Phillllll123/411-Group-Porject/CIRCUIT SCHEMATIC.pdf

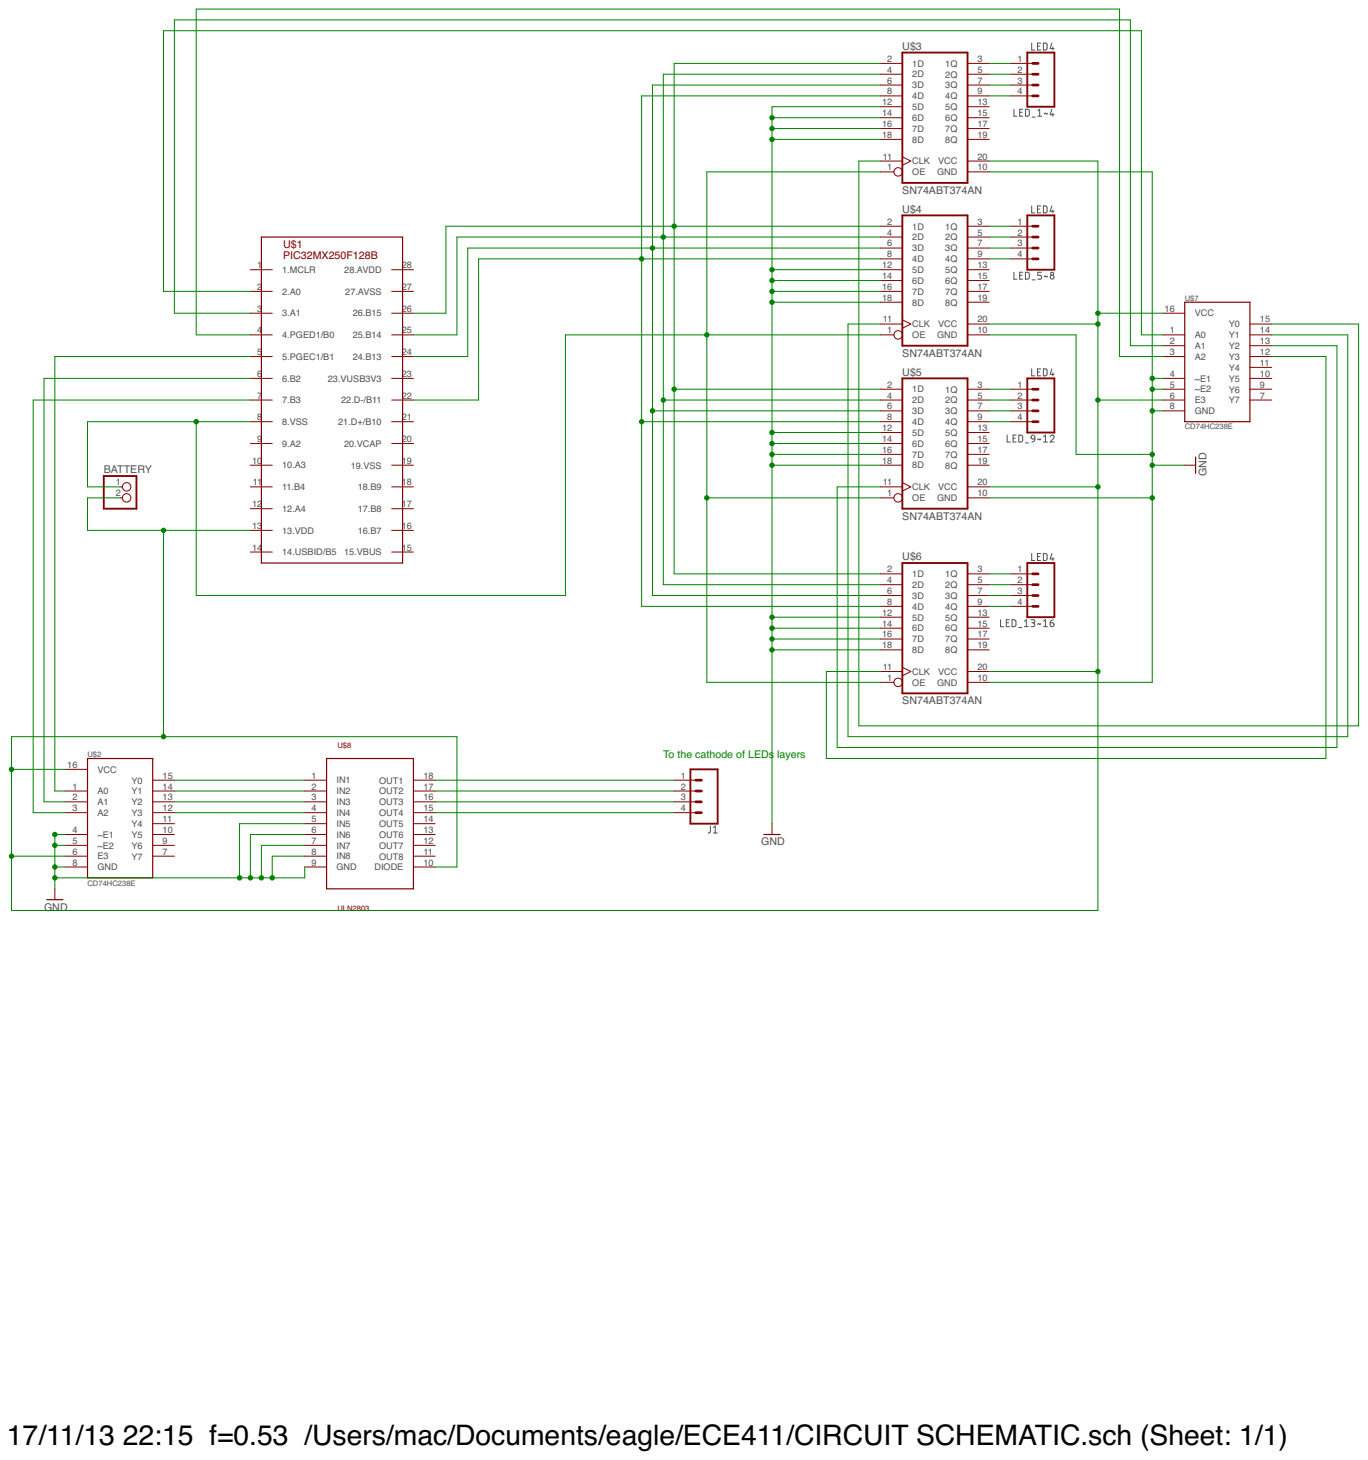
[picture p1: page 1]

4 | | 5 2
6 | | 7 3
8 | | 9 4
12 | | 15 17 19 20 GND

8 | 9 4
12 | 20 GND

4 | 5 2
6 | 7 3
12 | 15 17 19 20 GND

To the cathode of LEDs layers

14 Y0 2 | 17 OUT1 | 2
13 Y1 3 | 16 OUT2 | 3

17/11/13 22:15 f=0.53 /Users/mac/Documents/eagle/ECE411/CIRCUIT SCHEMATIC.sch (Sheet: 1/1)
