Phillllll123/411-Group-Porject/CIRCUIT Layout.pdf

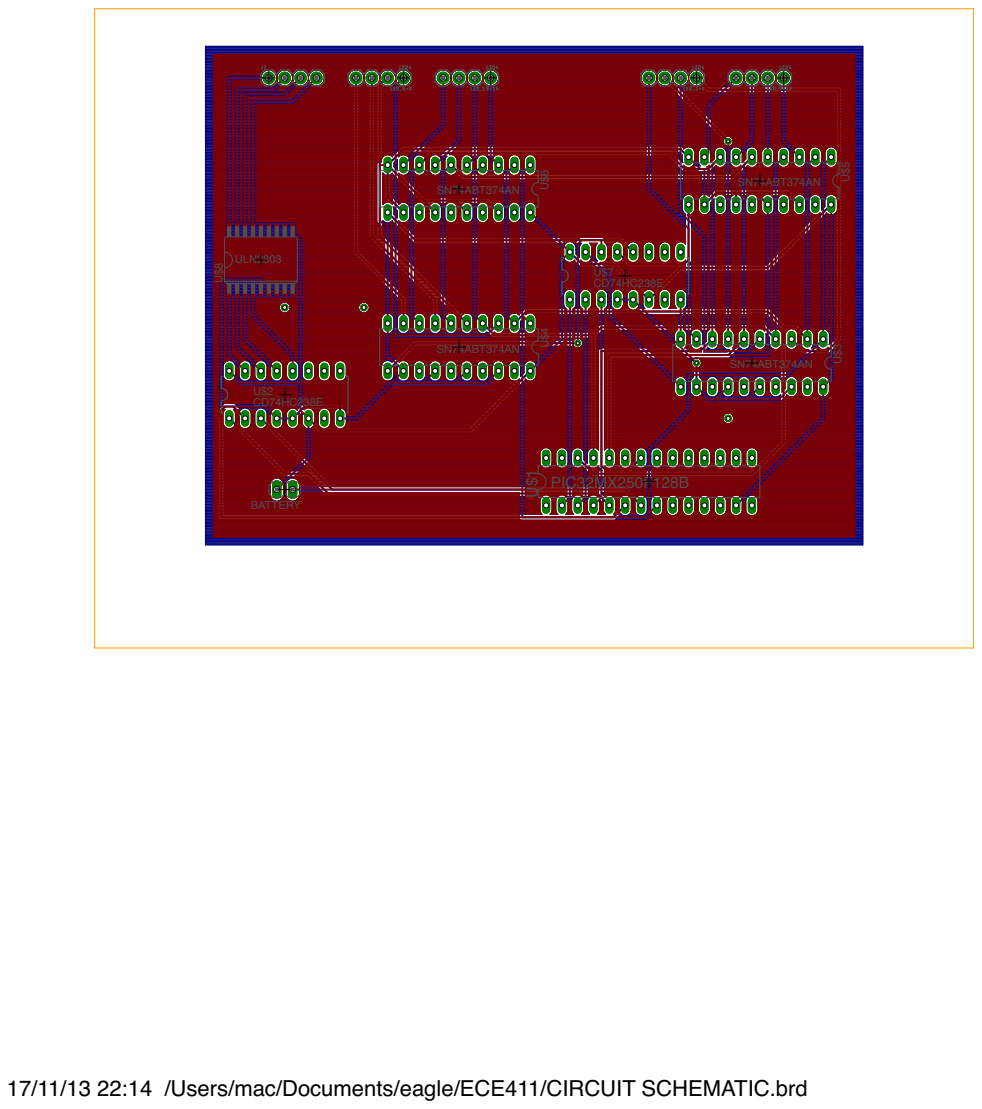
[picture p2: page 1]

U$2 | SN74ABT374AN | U$

17/11/13 22:14 /Users/mac/Documents/eagle/ECE411/CIRCUIT SCHEMATIC.brd
