Phillllll123/411-Group-Porject/LED Cube V6.pdf

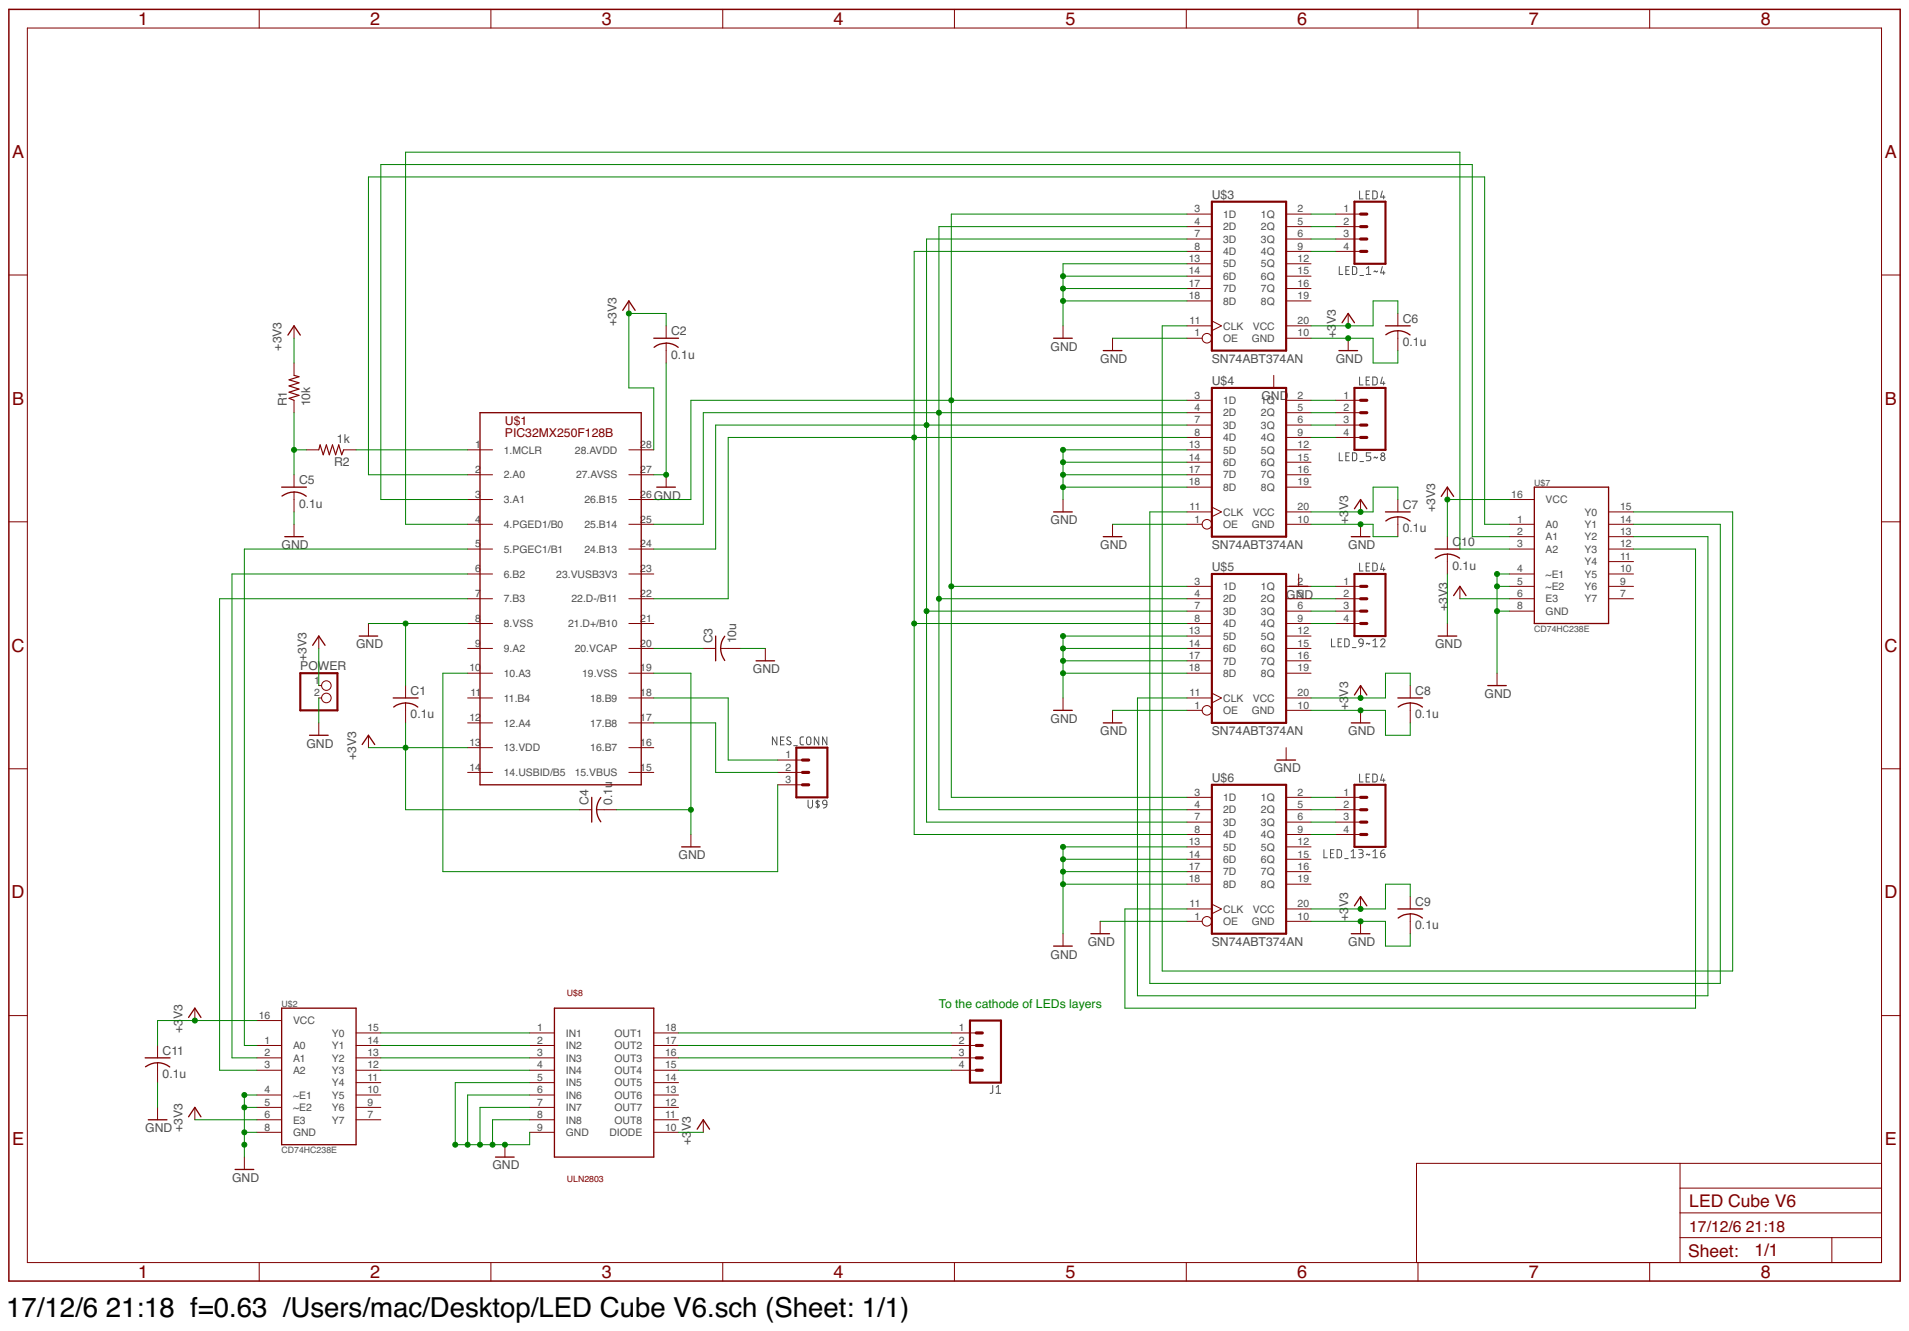
[picture p3: page 1]
