Phillllll123/411-Group-Porject/LED Cube V5.pdf

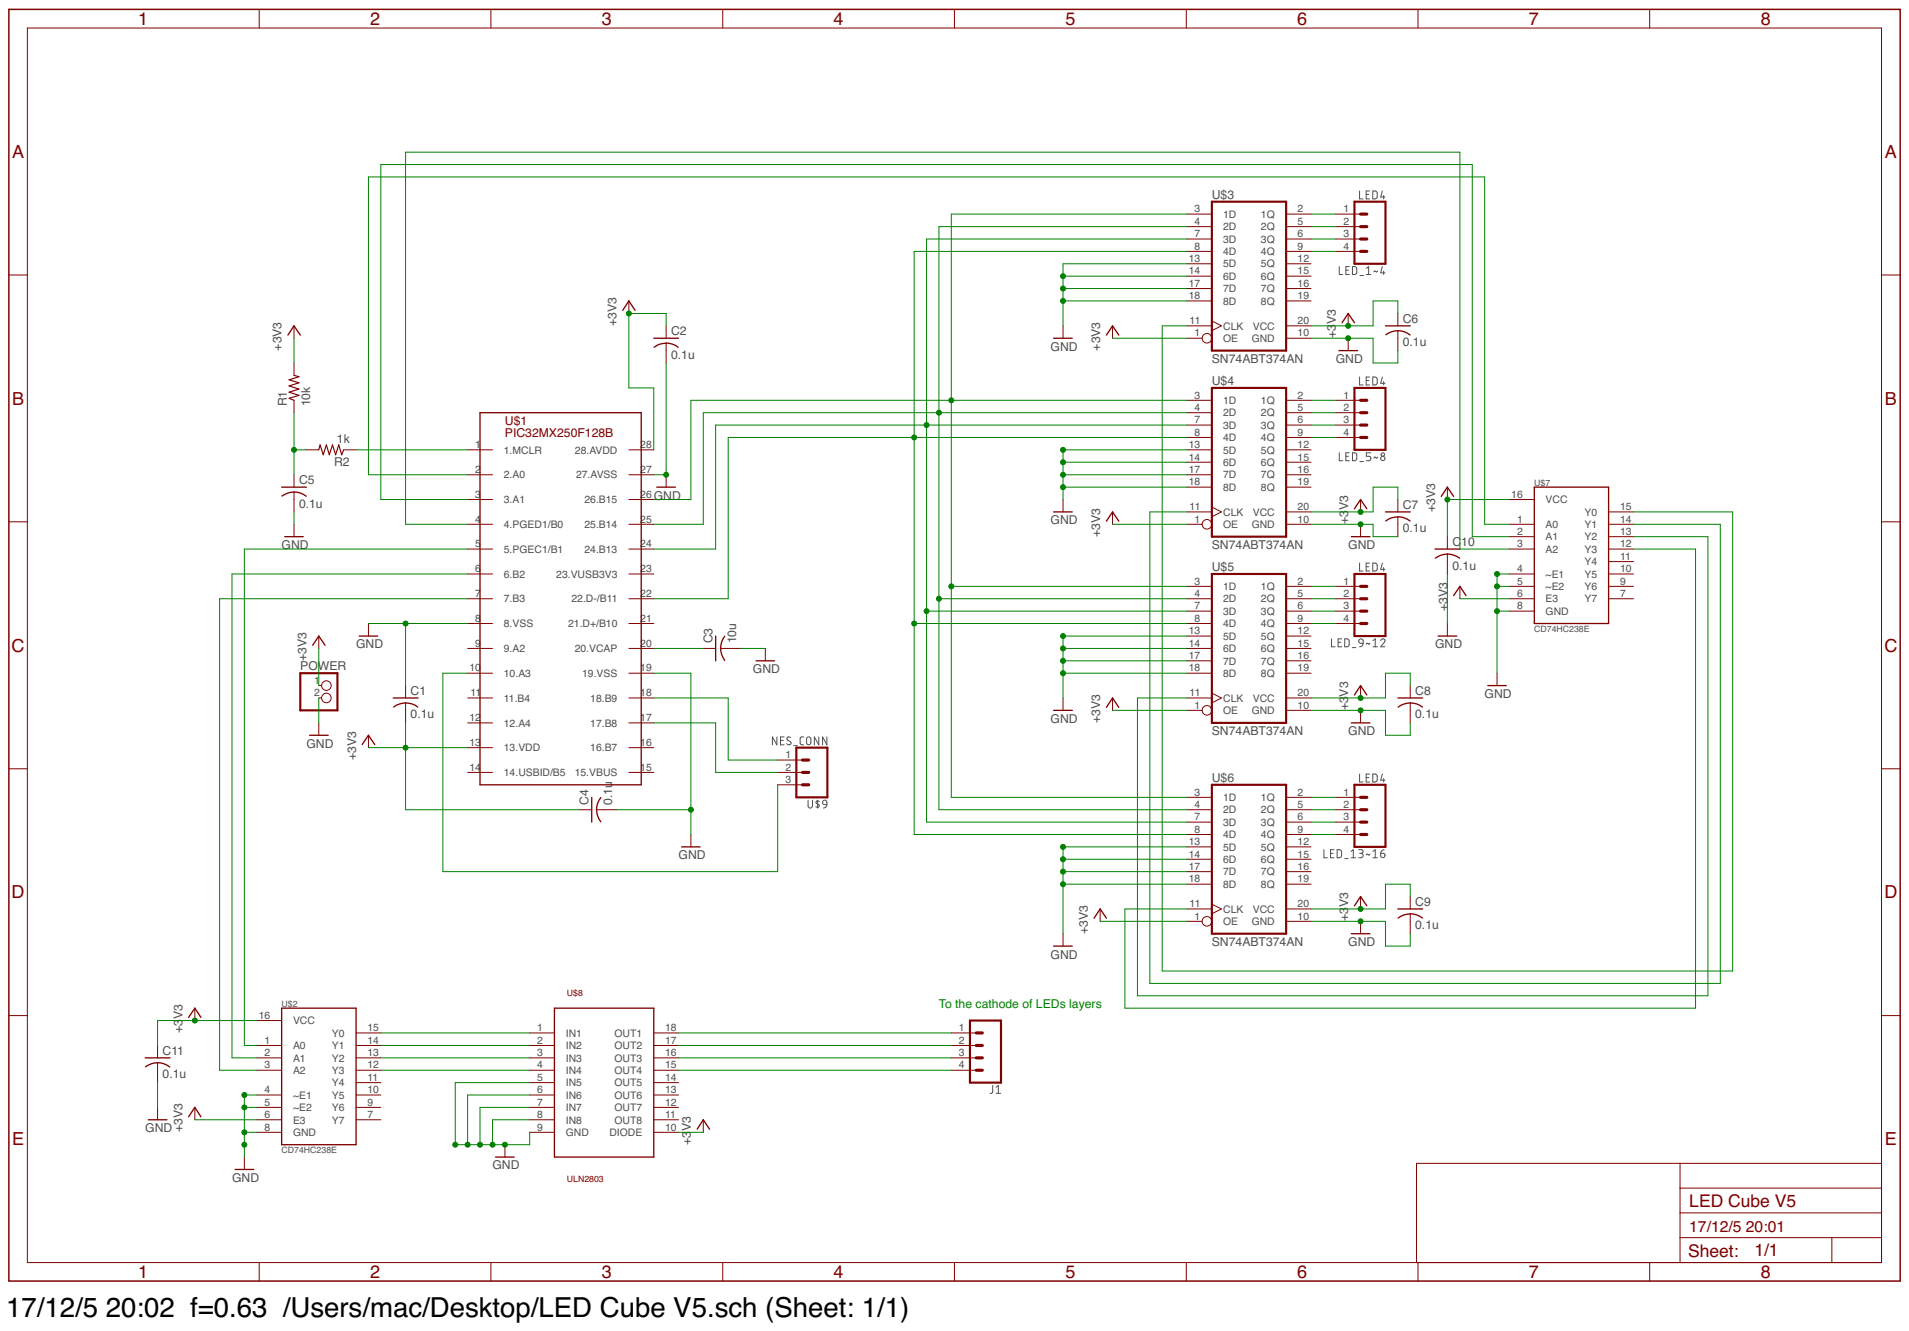
[picture p4: page 1]
