Phillllll123/411-Group-Porject/LED_CUBE_V4.brd

## EAGLE design LED_CUBE_V4.brd (2017-11-16)

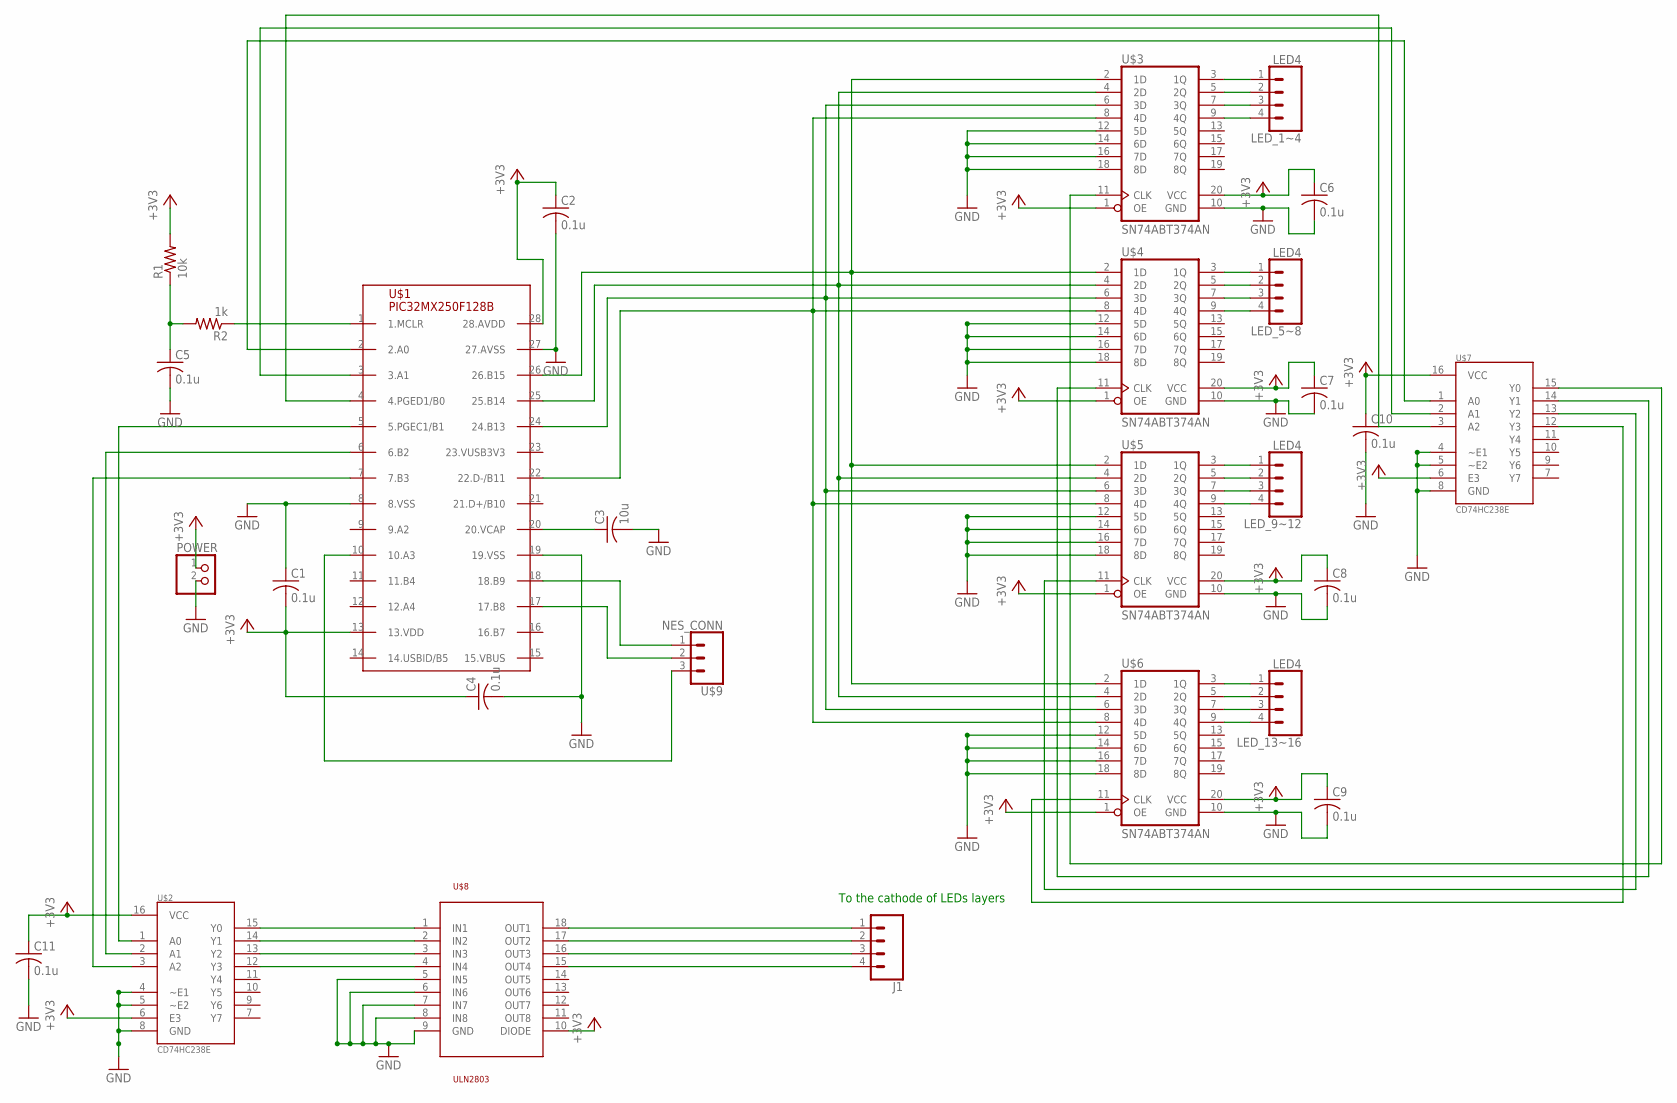
[picture p5: schematic LED_CUBE_V4.sch]

Parts:
C1, C2, C4, C5, C6, C7, C8, C9, C10, C11: 0.1u; C025-025X050
C3: 10u; C025-025X050
J1: CONN_04; 1X04
LED_1~4, LED_5~8, LED_9~12, LED_13~16: LED4; 1X04
POWER: PINHD-1X2; 1X02
R1: 10k; 0204/7
R2: 1k; 0204/7
U$1: PIC32MX250F128B; DIL28-3
U$2, U$7: CD74HC238E; DIL16
U$3, U$4, U$5, U$6: SN74ABT374AN; DIL20
U$8: ULN2803; SO18L
U$9: NES_CONN; 1X03

Connections:
+3V3: C1.2, C2.1, C4.1, C6.1, C7.1, C8.1, C9.1, C10.1, C11.1, POWER.1, R1.2, U$1.13 (13.VDD), U$1.28 (28.AVDD), U$2.6 (E3), U$2.16 (VCC), U$3.1 (OE), U$3.20 (VCC), U$4.1 (OE), U$4.20 (VCC), U$5.1 (OE), U$5.20 (VCC), U$6.1 (OE), U$6.20 (VCC), U$7.6 (E3), U$7.16 (VCC), U$8.10 (DIODE)
GND: C1.1, C2.2, C3.2, C4.2, C5.2, C6.2, C7.2, C8.2, C9.2, C10.2, C11.2, POWER.2, U$1.8 (8.VSS), U$1.19 (19.VSS), U$1.27 (27.AVSS), U$2.4 (~E1), U$2.5 (~E2), U$2.8 (GND), U$3.10 (GND), U$3.12 (5D), U$3.14 (6D), U$3.16 (7D), U$3.18 (8D), U$4.10 (GND), U$4.12 (5D), U$4.14 (6D), U$4.16 (7D), U$4.18 (8D), U$5.10 (GND), U$5.12 (5D), U$5.14 (6D), U$5.16 (7D), U$5.18 (8D), U$6.10 (GND), U$6.12 (5D), U$6.14 (6D), U$6.16 (7D), U$6.18 (8D), U$7.4 (~E1), U$7.5 (~E2), U$7.8 (GND), U$8.5 (IN5), U$8.6 (IN6), U$8.7 (IN7), U$8.8 (IN8), U$8.9 (GND)
LED1: LED_1~4.1, U$3.3 (1Q)
unnamed: U$2.15 (Y0), U$8.1 (IN1)
unnamed: U$2.14 (Y1), U$8.2 (IN2)
unnamed: U$2.13 (Y2), U$8.3 (IN3)
unnamed: U$2.12 (Y3), U$8.4 (IN4)
unnamed: U$1.10 (10.A3), U$9.3
unnamed: U$1.17 (17.B8), U$9.2
unnamed: U$1.18 (18.B9), U$9.1
unnamed: J1.1, U$8.18 (OUT1)
unnamed: J1.2, U$8.17 (OUT2)
unnamed: J1.3, U$8.16 (OUT3)
unnamed: J1.4, U$8.15 (OUT4)
unnamed: C3.1, U$1.20 (20.VCAP)
unnamed: U$1.5 (5.PGEC1/B1), U$2.1 (A0)
unnamed: U$1.6 (6.B2), U$2.2 (A1)
unnamed: U$1.7 (7.B3), U$2.3 (A2)
unnamed: LED_9~12.1, U$5.3 (1Q)
unnamed: U$1.26 (26.B15), U$3.2 (1D), U$4.2 (1D), U$5.2 (1D), U$6.2 (1D)
unnamed: U$1.25 (25.B14), U$3.4 (2D), U$4.4 (2D), U$5.4 (2D), U$6.4 (2D)
unnamed: U$1.22 (22.D-/B11), U$3.8 (4D), U$4.8 (4D), U$5.8 (4D), U$6.8 (4D)
unnamed: U$1.24 (24.B13), U$3.6 (3D), U$4.6 (3D), U$5.6 (3D), U$6.6 (3D)
unnamed: C5.1, R1.1, R2.2
unnamed: R2.1, U$1.1 (1.MCLR)
unnamed: U$3.11 (CLK), U$7.15 (Y0)
unnamed: U$4.11 (CLK), U$7.14 (Y1)
unnamed: U$1.3 (3.A1), U$7.2 (A1)
unnamed: U$1.4 (4.PGED1/B0), U$7.3 (A2)
unnamed: U$5.11 (CLK), U$7.13 (Y2)
unnamed: U$6.11 (CLK), U$7.12 (Y3)
unnamed: LED_9~12.2, U$5.5 (2Q)
unnamed: U$1.2 (2.A0), U$7.1 (A0)
unnamed: LED_1~4.2, U$3.5 (2Q)
unnamed: LED_1~4.3, U$3.7 (3Q)
unnamed: LED_1~4.4, U$3.9 (4Q)
unnamed: LED_9~12.3, U$5.7 (3Q)
unnamed: LED_9~12.4, U$5.9 (4Q)
unnamed: LED_5~8.1, U$4.3 (1Q)
unnamed: LED_5~8.2, U$4.5 (2Q)
unnamed: LED_5~8.3, U$4.7 (3Q)
unnamed: LED_5~8.4, U$4.9 (4Q)
unnamed: LED_13~16.1, U$6.3 (1Q)
unnamed: LED_13~16.2, U$6.5 (2Q)
unnamed: LED_13~16.3, U$6.7 (3Q)
unnamed: LED_13~16.4, U$6.9 (4Q)

Notes on the sheet:
To the cathode of LEDs layers

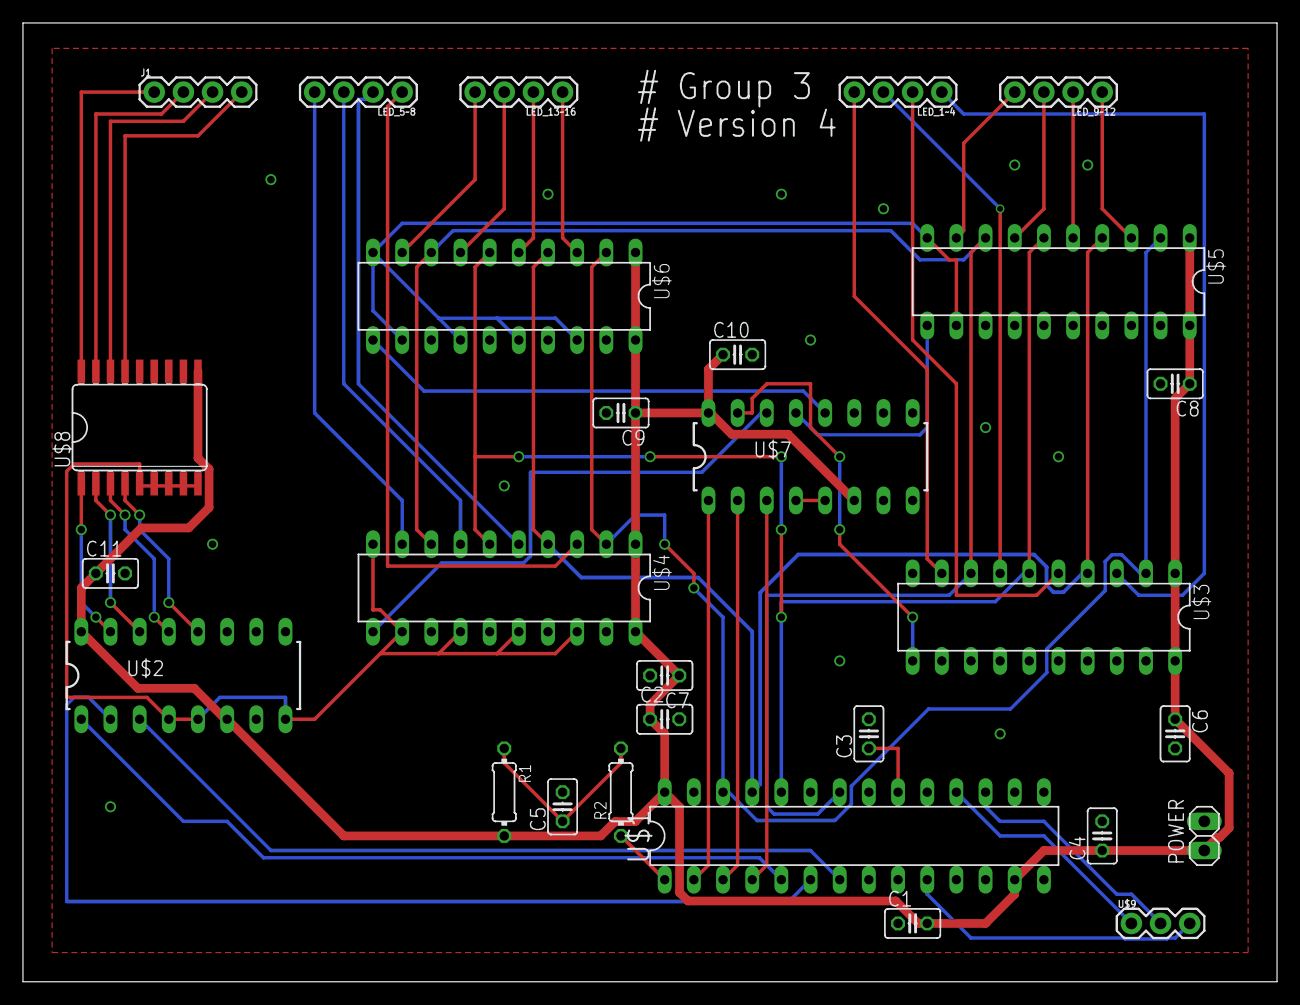
[picture p6: board LED_CUBE_V4.brd from above]

Board: 2 copper layers, 109.2 x 83.5 mm, 28 parts (0 on the bottom side), 46 nets.
