Phillllll123/411-Group-Porject/pin_manager.h

/**
  System Interrupts Generated Driver File

  @Company:
    Microchip Technology Inc.

  @File Name:
    pin_manager.h

  @Summary:
    This is the generated manager file for the MPLAB(c) Code Configurator device.  This manager
    configures the pins direction, initial state, analog setting.
    The peripheral pin select, PPS, configuration is also handled by this manager.

  @Description:
    This source file provides implementations for MPLAB(c) Code Configurator interrupts.
    Generation Information :
        Product Revision  :  MPLAB(c) Code Configurator - 4.26.1
        Device            :  PIC32MX250F128B
        Version           :  1.02
    The generated drivers are tested against the following:
        Compiler          :  XC32 1.42
        MPLAB             :  MPLAB X 3.55

    Copyright (c) 2013 - 2015 released Microchip Technology Inc.  All rights reserved.

    Microchip licenses to you the right to use, modify, copy and distribute
    Software only when embedded on a Microchip microcontroller or digital signal
    controller that is integrated into your product or third party product
    (pursuant to the sublicense terms in the accompanying license agreement).

    You should refer to the license agreement accompanying this Software for
    additional information regarding your rights and obligations.

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
*/

#ifndef _PIN_MANAGER_H
#define _PIN_MANAGER_H
/**
    Section: Includes
*/
#include <xc.h>
/**
    Section: Device Pin Macros
*/
/**
  @Summary
    Sets the GPIO pin, RA0, high using LATAbits.LATA0.

  @Description
    Sets the GPIO pin, RA0, high using LATAbits.LATA0.

  @Preconditions
    The RA0 must be set to an output.

  @Returns
    None.

  @Param
    None.

  @Example
    <code>
    // Set RA0 high (1)
    SEL0_SetHigh();
    </code>

*/
#define SEL0_SetHigh()          LATAbits.LATA0 = 1
/**
  @Summary
    Sets the GPIO pin, RA0, low using LATAbits.LATA0.

  @Description
    Sets the GPIO pin, RA0, low using LATAbits.LATA0.

  @Preconditions
    The RA0 must be set to an output.

  @Returns
    None.

  @Param
    None.

  @Example
    <code>
    // Set RA0 low (0)
    SEL0_SetLow();
    </code>

*/
#define SEL0_SetLow()           LATAbits.LATA0 = 0
/**
  @Summary
    Toggles the GPIO pin, RA0, using LATAbits.LATA0.

  @Description
    Toggles the GPIO pin, RA0, using LATAbits.LATA0.

  @Preconditions
    The RA0 must be set to an output.

  @Returns
    None.

  @Param
    None.

  @Example
    <code>
    // Toggle RA0
    SEL0_Toggle();
    </code>

*/
#define SEL0_Toggle()           LATAbits.LATA0 ^= 1
/**
  @Summary
    Reads the value of the GPIO pin, RA0.

  @Description
    Reads the value of the GPIO pin, RA0.

  @Preconditions
    None.

  @Returns
    None.

  @Param
    None.

  @Example
    <code>
    uint16_t portValue;

    // Read RA0
    postValue = SEL0_GetValue();
    </code>

*/
#define SEL0_GetValue()         PORTAbits.RA0
/**
  @Summary
    Configures the GPIO pin, RA0, as an input.

  @Description
    Configures the GPIO pin, RA0, as an input.

  @Preconditions
    None.

  @Returns
    None.

  @Param
    None.

  @Example
    <code>
    // Sets the RA0 as an input
    SEL0_SetDigitalInput();
    </code>

*/
#define SEL0_SetDigitalInput()  TRISAbits.TRISA0 = 1
/**
  @Summary
    Configures the GPIO pin, RA0, as an output.

  @Description
    Configures the GPIO pin, RA0, as an output.

  @Preconditions
    None.

  @Returns
    None.

  @Param
    None.

  @Example
    <code>
    // Sets the RA0 as an output
    SEL0_SetDigitalOutput();
    </code>

*/
#define SEL0_SetDigitalOutput() TRISAbits.TRISA0 = 0
/**
  @Summary
    Sets the GPIO pin, RA1, high using LATAbits.LATA1.

  @Description
    Sets the GPIO pin, RA1, high using LATAbits.LATA1.

  @Preconditions
    The RA1 must be set to an output.

  @Returns
    None.

  @Param
    None.

  @Example
    <code>
    // Set RA1 high (1)
    SEL1_SetHigh();
    </code>

*/
#define SEL1_SetHigh()          LATAbits.LATA1 = 1
/**
  @Summary
    Sets the GPIO pin, RA1, low using LATAbits.LATA1.

  @Description
    Sets the GPIO pin, RA1, low using LATAbits.LATA1.

  @Preconditions
    The RA1 must be set to an output.

  @Returns
    None.

  @Param
    None.

  @Example
    <code>
    // Set RA1 low (0)
    SEL1_SetLow();
    </code>

*/
#define SEL1_SetLow()           LATAbits.LATA1 = 0
/**
  @Summary
    Toggles the GPIO pin, RA1, using LATAbits.LATA1.

  @Description
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
    Toggles the GPIO pin, RA3, using LATAbits.LATA3.

  @Description
    Toggles the GPIO pin, RA3, using LATAbits.LATA3.

  @Preconditions
    The RA3 must be set to an output.

  @Returns
    None.

  @Param
    None.

  @Example
    <code>
    // Toggle RA3
    Latch_Toggle();
    </code>

*/
#define Latch_Toggle()           LATAbits.LATA3 ^= 1
/**
  @Summary
    Reads the value of the GPIO pin, RA3.

  @Description
    Reads the value of the GPIO pin, RA3.

  @Preconditions
    None.

  @Returns
    None.

  @Param
    None.

  @Example
    <code>
    uint16_t portValue;

    // Read RA3
    postValue = Latch_GetValue();
    </code>

*/
#define Latch_GetValue()         PORTAbits.RA3
/**
  @Summary
    Configures the GPIO pin, RA3, as an input.

  @Description
    Configures the GPIO pin, RA3, as an input.

  @Preconditions
    None.

  @Returns
    None.

  @Param
    None.

  @Example
    <code>
    // Sets the RA3 as an input
    Latch_SetDigitalInput();
    </code>

*/
#define Latch_SetDigitalInput()  TRISAbits.TRISA3 = 1
/**
  @Summary
    Configures the GPIO pin, RA3, as an output.

  @Description
    Configures the GPIO pin, RA3, as an output.

  @Preconditions
    None.

  @Returns
    None.

  @Param
    None.

  @Example
    <code>
    // Sets the RA3 as an output
    Latch_SetDigitalOutput();
    </code>

*/
#define Latch_SetDigitalOutput() TRISAbits.TRISA3 = 0
/**
  @Summary
    Sets the GPIO pin, RB0, high using LATBbits.LATB0.

  @Description
    Sets the GPIO pin, RB0, high using LATBbits.LATB0.

  @Preconditions
    The RB0 must be set to an output.

  @Returns
    None.

  @Param
    None.

  @Example
    <code>
    // Set RB0 high (1)
    SEL2_SetHigh();
    </code>

*/
#define SEL2_SetHigh()          LATBbits.LATB0 = 1
/**
  @Summary
    Sets the GPIO pin, RB0, low using LATBbits.LATB0.

  @Description
    Sets the GPIO pin, RB0, low using LATBbits.LATB0.

  @Preconditions
    The RB0 must be set to an output.

  @Returns
    None.

  @Param
    None.

  @Example
    <code>
    // Set RB0 low (0)
    SEL2_SetLow();
    </code>

*/
#define SEL2_SetLow()           LATBbits.LATB0 = 0
/**
  @Summary
    Toggles the GPIO pin, RB0, using LATBbits.LATB0.

  @Description
    Toggles the GPIO pin, RB0, using LATBbits.LATB0.

  @Preconditions
    The RB0 must be set to an output.

  @Returns
    None.

  @Param
    None.

  @Example
    <code>
    // Toggle RB0
    SEL2_Toggle();
    </code>

*/
#define SEL2_Toggle()           LATBbits.LATB0 ^= 1
/**
  @Summary
    Reads the value of the GPIO pin, RB0.

  @Description
    Reads the value of the GPIO pin, RB0.

  @Preconditions
    None.

  @Returns
    None.

  @Param
    None.

  @Example
    <code>
    uint16_t portValue;

    // Read RB0
    postValue = SEL2_GetValue();
    </code>

*/
#define SEL2_GetValue()         PORTBbits.RB0
/**
  @Summary
    Configures the GPIO pin, RB0, as an input.

  @Description
    Configures the GPIO pin, RB0, as an input.

  @Preconditions
    None.

  @Returns
    None.

  @Param
    None.

  @Example
    <code>
    // Sets the RB0 as an input
    SEL2_SetDigitalInput();
    </code>

*/
#define SEL2_SetDigitalInput()  TRISBbits.TRISB0 = 1
/**
  @Summary
    Configures the GPIO pin, RB0, as an output.

  @Description
    Configures the GPIO pin, RB0, as an output.

  @Preconditions
    None.

  @Returns
    None.

  @Param
    None.

  @Example
    <code>
    // Sets the RB0 as an output
    SEL2_SetDigitalOutput();
    </code>

*/
#define SEL2_SetDigitalOutput() TRISBbits.TRISB0 = 0
/**
  @Summary
    Sets the GPIO pin, RB1, high using LATBbits.LATB1.

  @Description
    Sets the GPIO pin, RB1, high using LATBbits.LATB1.

  @Preconditions
    The RB1 must be set to an output.

  @Returns
    None.

  @Param
    None.

  @Example
    <code>
    // Set RB1 high (1)
    CAT0_SetHigh();
    </code>

*/
#define CAT0_SetHigh()          LATBbits.LATB1 = 1
/**
  @Summary
    Sets the GPIO pin, RB1, low using LATBbits.LATB1.

  @Description
    Sets the GPIO pin, RB1, low using LATBbits.LATB1.

  @Preconditions
    The RB1 must be set to an output.

  @Returns
    None.

  @Param
    None.

  @Example
    <code>
    // Set RB1 low (0)
    CAT0_SetLow();
    </code>

*/
#define CAT0_SetLow()           LATBbits.LATB1 = 0
/**
  @Summary
    Toggles the GPIO pin, RB1, using LATBbits.LATB1.

  @Description
    Toggles the GPIO pin, RB1, using LATBbits.LATB1.

  @Preconditions
    The RB1 must be set to an output.

  @Returns
    None.

  @Param
    None.

  @Example
    <code>
    // Toggle RB1
    CAT0_Toggle();
    </code>

*/
#define CAT0_Toggle()           LATBbits.LATB1 ^= 1
/**
  @Summary
    Reads the value of the GPIO pin, RB1.

  @Description
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
    Data_SetDigitalOutput();
    </code>

*/
#define Data_SetDigitalOutput() TRISBbits.TRISB4 = 0

/**
    Section: Function Prototypes
*/
/**
  @Summary
    Configures the pin settings of the PIC32MX250F128B
    The peripheral pin select, PPS, configuration is also handled by this manager.

  @Description
    This is the generated manager file for the MPLAB(c) Code Configurator device.  This manager
    configures the pins direction, initial state, analog setting.
    The peripheral pin select, PPS, configuration is also handled by this manager.

  @Preconditions
    None.

  @Returns
    None.

  @Param
    None.

  @Example
    <code>
    void SYSTEM_Initialize(void)
    {
        // Other initializers are called from this function
        PIN_MANAGER_Initialize();
    }
    </code>

*/
void PIN_MANAGER_Initialize(void);

#endif
